donfroula/Camera-Shutter-Speed-Tester/schematic.jpg

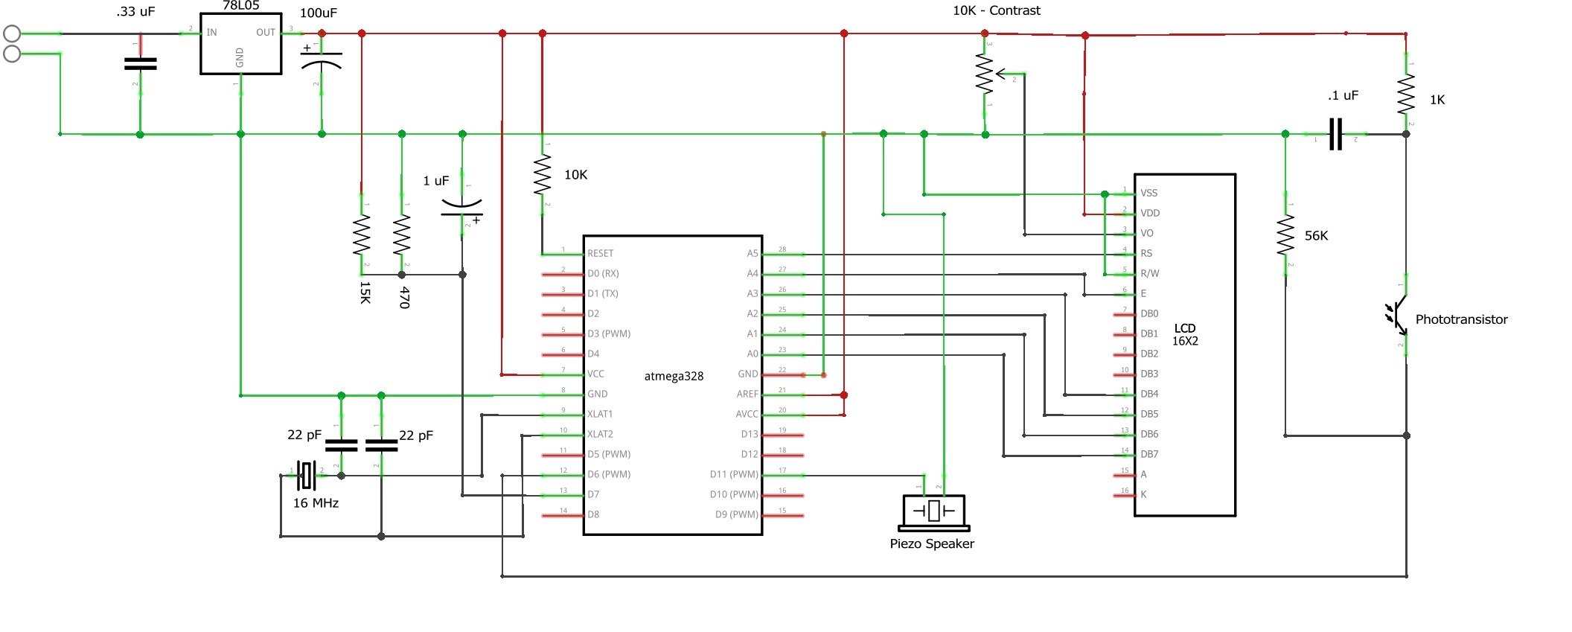
schematic.jpg
